juan-villota-b/Analizador-Trifasico-IoT/documentation/diagrama-de-bloques-v2.png

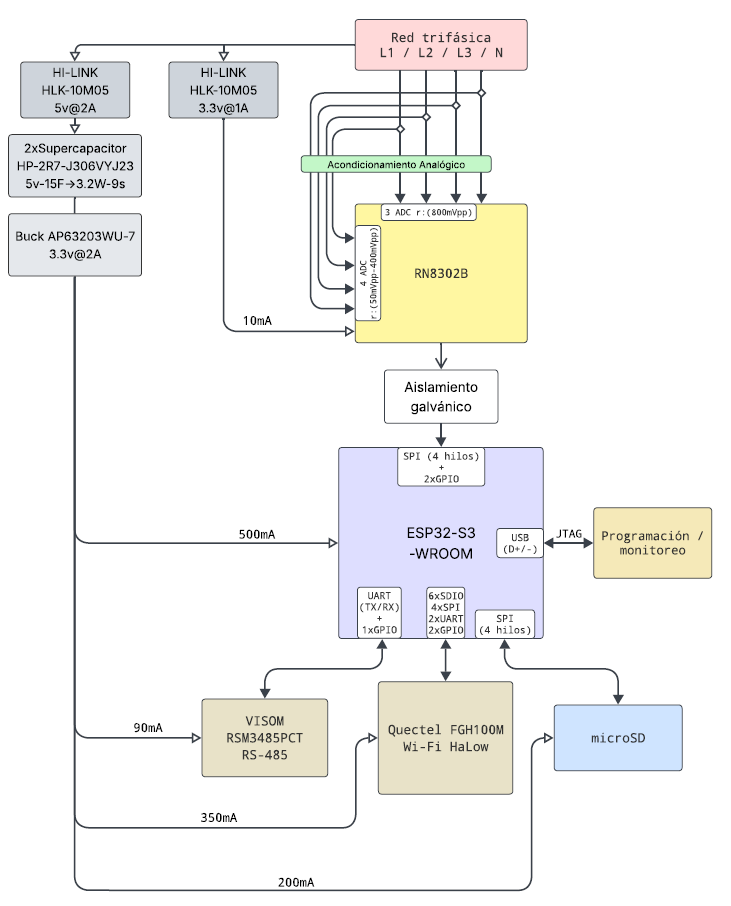
documentation/diagrama-de-bloques-v2.png
