juan-villota-b/Analizador-Trifasico-IoT/references/reference-designs/EVALLSTPM34-V3/evalstpm34_cad/EVALSTPM33 V3 BOM.xlsx

Sheet: STPM33 V3
 |  | STPM33 V3
item | qty | reference designator | value/type | footprint | assembly instructions | distrelec | rs | other provider | part number name/notes
1 | 9 | C2,C6,C7,C8,C19,C22,C27,C29,C32 | 100n | sm/c_0603 |  | 823499 |  |  | or equivalent
2 | 11 | C9,C11,C12,C13,C14,C15,C18,C21,C26,C28,C31 | 150p | sm/c_0402 |  | 831827 |  |  | or equivalent
3 | 3 | C10,C25,C33 | 10n | sm/c_0603 |  | 830121 |  |  | or equivalent
4 | 2 | C16,C17 | 15p | sm/c_0603 |  | 838382 |  |  | or equivalent
5 | 1 | C3 | 4.7U Tantalio | sm/ct_7343_12 |  |  |  | Farnell | 9753800
6 | 1 | C20 | 4.7u | sm/c_0805 |  | 823504 |  |  | or equivalent
7 | 1 | C23 | 100u 10V | CPCYL/D.200/LS.100/.031 |  |  |  | Farnell | 2346495
8 | 1 | C24 | 22n | sm/c_0603 |  | 823493 |  |  | or equivalent
 |  | C34 | 22n | sm/c_0603 | NON MONTARE
9 | 2 | C30,C1 | 1u | sm/c_0603 |  | 823495 |  |  | or equivalent
10 | 3 | D1,D2,D3 | ESDAXLC6-IBU2 | SM/C_0201 |  |  |  | STMicroelectronics
11 | 3 | DL1,DL2,DL3 | Low pwr SMD LED | LEDSMD |  | 631039 |  |  | or equivalent
12 | 1 | J1 | USB connector | Micro USB |  |  |  | Molex | 47590-0001
 |  | J2 |  |  | NON MONTARE
13 | 2 | J4,J11 | 1 row male header 2.54mm | BLKCON.100/VH/TM1SQS/W.100/3 |  | 127232 |  |  | or equivalent
14 | 2 | J5,J6 | 2 rows male header 2.54mm | BLKCON.100/VH/TM2OE/W.200/8 |  | 127234 |  |  | or equivalent
15 | 1 | J7 | PCB supply screw connector | MORS2 |  | 140276 |  |  | or equivalent
16 | 2 | J8,J9 | THT PCB Faston Connector | FASTON |  | 450280 |  |  | or equivalent
 |  | J10 | THT PCB Faston Connector | FASTON | NON MONTARE
17 | 6 | L1,L2,L3,L4,L5,L6 | TDK Ferrite Beads MM71608Y152E | SM/R_0603 |  |  |  | Farnell | 1855387RL
 |  | L7 | TDK Ferrite Beads MM71608Y152E | SM/R_0603 | NON MONTARE
18 | 1 | RS1 | BKW-M-R0003-5.0 | ISABH_SHUNT |  |  |  | Isabellenhuette | BKW-M-R0003-5.0
19 | 5 | R1,R7,R8,R9,R10 | 10K | SM/R_0603 |  |  |  |  | resistor, 1% tol., 100ppm/°C
20 | 1 | R2 | 22K | SM/R_0603 |  |  |  |  | resistor, 1% tol., 100ppm/°C
21 | 2 | R3,R11 | 100R | SM/R_0603 |  |  |  |  | resistor, 1% tol., 100ppm/°C
22 | 1 | R4 | 1M | SM/R_0603 |  |  |  |  | resistor, 1% tol., 100ppm/°C
23 | 3 | R5,R6,R28 | 4.7K | SM/R_0603 |  |  |  |  | resistor, 1% tol., 100ppm/°C
24 | 3 | R12,R13,R14 | 270K miniMELF resistor | SM/R_1206 |  | 713132 |  |  | or equivalent
 |  | R23,R24,R25 | 270K miniMELF resistor | SM/R_1206 | NON MONTARE
25 | 1 | R15 | 470R miniMELF resistor | SM/R_1206 |  | 713066 |  |  | or equivalent
 |  | R26 | 470R miniMELF resistor | SM/R_1206 | NON MONTARE
26 | 1 | R21 | 6R miniMELF resistor | SM/R_1206 |  | 713021 |  |  | or equivalent
 |  | R16 | 6R miniMELF resistor | SM/R_1206 | NON MONTARE
27 | 4 | R17,R18,R20,R22 | 1K | SM/R_0603 |  |  |  |  | resistor, 1% tol., 100ppm/°C
 |  | R19 | 0R | SM/R_0603 | NON MONTARE
28 | 1 | R27 | 470R | SM/R_0603 |  |  |  |  | resistor, 1% tol., 100ppm/°C
29 | 1 | SW1 | 3-way SPST Dip-Switch | DIP.100/6/W.300/L.375 |  |  | 745-5167
30 | 1 | T2 | VAC 4626-X002 | BLKCON.100/VH/TM1SQS/W.100/2 |  |  |  | Vacuumschmelze | 4626-X002
 | 1 | T1 | VAC 4626-X002 | BLKCON.100/VH/TM1SQS/W.100/2 | NON MONTARE
31 | 1 | U1 | CP2102 | QFN28L 5X5 0.5 |  |  |  | SiLabs | CP2102-GM
32 | 1 | U2 | STISO621 | SOG.050/8/WG.275/L.250 |  |  |  | STMicroelectronics | Si8621EC-B-IS
33 | 1 | U3 | STPM33 | QFN32L 5X5 0.5 |  |  |  | STMicroelectronics
34 | 1 | Y1 | 16MHz Crystal, HC49US package | XTAL |  | 335035

Sheet: PUBLISHING
 | EVALSTPM33 V3
 | Bill of material
Description | Designator | Qty | Value | Footprint | Manufacturer | Comment
SMD capacitor | C2,C6,C7,C8,C19,C22,C27,C29,C32 |  | 100n | sm/c_0603
SMD capacitor | C9,C11,C12,C13,C14,C15,C18,C21,C26,C28,C31 |  | 150p | sm/c_0402
SMD capacitor | C10,C25,C33 |  | 10n | sm/c_0603
SMD capacitor | C16,C17 |  | 15p | sm/c_0603
SMD capacitor | C20 |  | 4.7u | sm/c_0805
SMD capacitor | C3 |  | 4.7u Tantalium | sm/ct_7343_12 | Farnell
Electrolytic capacitor | C23 |  | 100u 10V | CPCYL/D.200/LS.100/.031 | Farnell
SMD capacitor | C24 |  | 22n | sm/c_0603
SMD capacitor | C34 |  | 22n | sm/c_0603 |  | DO NOT MOUNT
SMD capacitor | C30,C1 |  | 1u | sm/c_0603
SMD Transient suppressor | D1,D2,D3 |  | ESDAXLC6-IBU2 | SM/C_0201 | STMicroelectronics
SMD LED | DL1,DL2,DL3 |  |  | LEDSMD
microUSB female plug | J1 |  |  | Micro USB | Molex
 | J2 |  |  |  |  | DO NOT MOUNT
1 row male header 2.54mm | J4,J11 |  |  | BLKCON.100/VH/TM1SQS/W.100/3
2 rows male header 2.54mm | J5,J6 |  |  | BLKCON.100/VH/TM2OE/W.200/8
16AWG 5.08mm screw connector | J7 |  |  | MORS2
PCB TH Faston terminal | J8,J9 |  |  | FASTON
PCB TH Faston terminal | J10 |  |  | FASTON |  | DO NOT MOUNT
SMD ferrite bead | L1,L2,L3,L4,L5,L6 |  | TDK Ferrite Beads MM71608Y152E | SM/R_0603 | Farnell
SMD ferrite bead | L7 |  | TDK Ferrite Beads MM71608Y152E | SM/R_0603 | Farnell | DO NOT MOUNT
Shunt current sensor | RS1 |  | BKW-M-R0003-5.0 | ISABH_SHUNT | Isabellenhuette
SMD resistor | R1,R7,R8,R9,R10 |  | 10K | SM/R_0603
SMD resistor | R2 |  | 22K | SM/R_0603
SMD resistor | R3,R11 |  | 100R | SM/R_0603
SMD resistor | R4 |  | 1M | SM/R_0603
SMD resistor | R5,R6,R28 |  | 4.7K | SM/R_0603
SMD resistor | R12,R13,R14 |  | 270K miniMELF resistor | SM/R_1206
SMD resistor | R23,R24,R25 |  | 270K miniMELF resistor | SM/R_1206 |  | DO NOT MOUNT
SMD resistor | R15 |  | 470R miniMELF resistor | SM/R_1206
SMD resistor | R26 |  | 470R miniMELF resistor | SM/R_1206 |  | DO NOT MOUNT
SMD resistor | R16 |  | 6R miniMELF resistor | SM/R_1206 |  | DO NOT MOUNT
SMD resistor | R17,R18,R20,R22 |  | 1K | SM/R_0603
SMD resistor | R19 |  | 0R | SM/R_0603 |  | DO NOT MOUNT
SMD resistor | R21 |  | 6R miniMELF resistor | SM/R_1206
SMD resistor | R27 |  | 470R | SM/R_0603
3-way 2-state DIP switch | SW1 |  |  | DIP.100/6/W.300/L.375
Current Transformer | T1 |  | VAC 4626-X002 | BLKCON.100/VH/TM1SQS/W.100/2 | Vacuumschmelze | DO NOT MOUNT
Current Transformer | T2 |  | VAC 4626-X002 | BLKCON.100/VH/TM1SQS/W.100/2 | Vacuumschmelze
CP2102 IC-QFN28 | U1 |  | CP2102 | QFN28L 5X5 0.5 | SiLabs
STISO621 IC-SO8W | U2 |  | STISO621W | SOG.050/8/WG.275/L.250 | STMicroelectronics
STPM34 IC-QFN32 | U3 |  | STPM34 | QFN32L 5X5 0.5 | STMicroelectronics
16MHz Crystal, HC49US package | Y1 |  | 16MHz Crystal, HC49US package | XTAL
