juan-villota-b/Analizador-Trifasico-IoT/references/reference-designs/EVALLSTPM34-V3/LCSC__WM2611110226_20261111053323.csv

LCSC Part Number | Manufacture Part Number | Manufacturer | Customer NO. | Package | Description | RoHS | Quantity | Unit Price($) | Ext.Price($) | Estimated lead time (business days) | Updated lead time | Date Code / Lot No.
C7436773 | HP-2R7-J306VYJ23 | KAMCAP |  | Through Hole,D18xL26mm | 0%~+30% 2.7V 30F 22mΩ@1kHz Through Hole,D18xL26mm Aluminum Electrolytic Capacitors | YES | 2 | 1.47 | 2.94
C19674267 | 049SS2-8.192F12DZLAL | HCI |  | HC-49S-SMD | Crystal 8.192MHz ±20ppm 12pF 60Ω HC-49S-SMD | YES | 5 | 0.1346 | 0.67
C53144700 | TF-CARD-9P | BXCONN |  | SMD | -25℃~+90℃ Push-Push 1.8mm Connector and Ejector MicroSD Card (TF Card) SMD PC Card Sockets RoHS | YES | 10 | 0.0459 | 0.46
C882105 | RSM3485PCT | VISOM |  | DIP-9 | 3.15V~3.45V 9.6Kbps 64 No DIP-9 Drivers, Receivers, Transceivers | YES | 1 | 2.4222 | 2.42
C2913197 | ESP32-S3-WROOM-1-N4 | ESPRESSIF |  | SMD,25.5x18mm | 2.4GHz ESP32-S3 On-board PCB Antenna -103.5dBm SMD,25.5x18mm RF Transceiver Modules and Modems RoHS | YES | 1 | 4.3075 | 4.31
C49291885 | C50126V-4P0G56 | JXTCONN |  | Through Hole,P=5mm | 0.5~2.5 18A -40℃~+105℃ 250V 1x4P Green 14~26 Through Hole 4 1 5mm Through Hole,P=5mm Wire to Board | YES | 5 | 0.1402 | 0.70
C19189087 | HX PJ-320A-3P DIP | hanxia |  | Through Hole | 3.5mm Headphone Jack 500mA 30V Through Hole | YES | 10 | 0.0424 | 0.42
C7465187 | B0503S-1WR3 | EVISUN |  | SIP,11.7x6mm | Isolated Module DC DC Converter 3.3V 303mA 4.5V~5.5V Input | YES | 1 | 1.0919 | 1.09
C47115461 | HX1002-GEC | HEXIN |  | SOT-23-5L | Buck Switching Regulator IC Fixed 3.3V 1 Output SOT-23-5L | YES | 10 | 0.074 | 0.74
C571196 | ISO7741DWR | TI |  | SOIC-16-300mil | 100kV/us SOIC-16-300mil Digital Isolators RoHS | YES | 1 | 1.5216 | 1.52
C22381391 | RN8302B(V3) | RENERGY |  | LQFP-44(10x10) | 3V~3.6V SPI 4.4mA LQFP-44(10x10) Energy Metering | YES | 1 | 1.7333 | 1.73
C1527439 | MOV-14D471K | BOURNS |  | Through Hole,P=7.5mm | 470V 4.5kA Varistor Through Hole,P=7.5mm | YES | 3 | 0.4328 | 1.30
C861150 | RT0603BRD07165KL | YAGEO |  | 0603 | 100mW 165kΩ 75V Thin Film Resistor ±25ppm/℃ ±0.1% 0603 Chip Resistor - Surface Mount RoHS | YES | 20 | 0.0516 | 1.03
C2791987 | HQ03W5F510KT5E | UNI-ROYAL |  | 0603 | 5.1Ω ±1% 200mW 0603 Thick Film Resistor AEC-Q200 | YES | 10 | 0.0061 | 0.06
C54920849 | HRC0603F1200ENTN | HWA CHN |  | 0603 | 100mW 120Ω 50V Thick Film Resistor ±1% ±100ppm/℃ 0603 Chip Resistor - Surface Mount | YES | 100 | 0.0012 | 0.12
C2758800 | HP122WJ039JT4E | UNI-ROYAL |  | 2512 | 3.9Ω 2W 300V Thick Film Resistor ±5% 2512 Chip Resistor - Surface Mount | YES | 10 | 0.0324 | 0.32
C2907002 | FRC0603F1001TS | FOJAN |  | 0603 | 1kΩ ±1% 100mW 0603 Thick Film Resistor | YES | 100 | 0.0021 | 0.21
C53224186 | 1RC0603F1002 | SAE |  | 0603 | 10kΩ 100mW 75V Thick Film Resistor ±100ppm/℃ ±1% 0603 Chip Resistor - Surface Mount | YES | 100 | 0.0021 | 0.21
C52746092 | HLK-10M05T | HI-LINK |  | Through Hole,39x23.5mm | Through Hole,39x23.5mm AC DC Converters RoHS | YES | 1 | 3.1018 | 3.10
C55058769 | JFC2410-0200TS | JDTfuse |  | 2410 | Surface Mount Fuse 200mA 250V 2410 Fuses | YES | 5 | 0.1124 | 0.56
C908219 | SM712 | FUXINSEMI |  | SOT-23 | 20VC Clamp 18A Ipp ESD DIODE SOT-23 | YES | 10 | 0.0424 | 0.42
C145190 | MBRA210LT3G | onsemi |  | SMA(DO-214AC) | Diode 10V 2A Surface Mount SMA(DO-214AC) | YES | 5 | 0.333 | 1.67
C165071 | 0603B333K500CT | Walsin |  | 0603 | 33nF ±10% 50V Ceramic Capacitor X7R 0603 | YES | 50 | 0.0099 | 0.50
C41435083 | RVT1E4R7M0405 | ROQANG |  | SMD,D4xL5.4mm | 4.7uF ±20% 25V Aluminum Electrolytic Capacitors | YES | 20 | 0.022 | 0.44
C19666 | CL10A475KO8NNNC | Samsung Electro-Mechanics |  | 0603 | 4.7uF ±10% 16V Ceramic Capacitor X5R 0603 | YES | 10 | 0.0151 | 0.15
C346207 | CL10C150JB81PNC | Samsung Electro-Mechanics |  | 0603 | 15pF ±5% 50V Ceramic Capacitor C0G 0603 | YES | 50 | 0.0133 | 0.67
C42429166 | ZNR4020ST4R7M | ZE |  | SMD,4x4mm | 2A 4.7uH ±20% 75mΩ 2.5A Magnetic Shielded Inductor SMD,4x4mm Fixed Inductors RoHS | YES | 5 | 0.043 | 0.22
