juan-villota-b/Analizador-Trifasico-IoT/hardware/altium/Project Outputs for Analizador_trifasico_IoT_pcb/Analizador_trifasico_IoT_pcb.xlsx

Name | Description | Quantity | Manufacturer 1 | Manufacturer Part Number 1 | Supplier 1 | Supplier Part Number 1 | Supplier Unit Price 1 | Supplier Subtotal 1
YAGEO CC0603JRNPO9BN150 | Capacitance:15pF Tolerance:±5% Tolerance:±5% Voltage Rating:50V Temperature Coefficient:C0G | 2 | Chinocera | HGC0603G0150J500NTHJ | LCSC | C465156
CL10B105KB8NQNC | Capacitance:1uF Tolerance:±20% Tolerance:±20% Voltage Rating:50V Ripple Current:- Equivalent Series Resistance(ESR):- Diameter:4mm Height - Seated (Max):5.4mm Lifetime:1000hrs@105℃ Operating Temperature:-45℃~+105℃ Operating Temperature:-45℃~+105℃ | 2 | Samsung Electro-Mechanics | CL10B105KB8NQNC | LSCS | C5199872
AIDE CAPACITOR 0603X7R104K250NT | CAP CER 100nF 25V X7R 0603 | 12 | AIDE CAPACITOR | 0603X7R104K250NT | LCSC | C48579280
muRata GRM21BR61C106KE15L | CAP CER 10uF 16V X5R 0805 | 8 | Murata | GRM21BR61C106KE15L | LCSC | C77075 | 0.0366 | 0.366
hp-2r7-j306vyj23 | Capacitance:30F Tolerance:0%~+30% Tolerance:0%~+30% Voltage Rating:2.7V Pin Spacing:7.5mm Diameter:18mm Height - Seated (Max):26mm Operating Temperature:-40℃~+70℃ Operating Temperature:-40℃~+70℃ | 2 | KAMCAP | HP-2R7-J306VYJ23 | LCSC | C7436773
Samsung Electro-Mechanics | CAP CER 4.7uF 16V X5R 0603 | 1 | Samsung Electro-Mechanics | CL10A475KO8NNNC | LCSC | C19666 | 0.0151 | 0.151
Chinocera HGC0805R5226K100NSLJ | CAP CER 22uF 10V X5R 0805 | 3 | Suzhou Hangjing Elec&Tech Co.,Ltd | 049SS2-8.192F12DZLAL | LCSC | C7432777
rvt1e4r7m0405 | Capacitance:4.7uF Tolerance:±20% Tolerance:±20% Voltage Rating:25V Diameter:4mm Height - Seated (Max):5.4mm Operating Temperature:-40℃~+105℃ Operating Temperature:-40℃~+105℃ | 1 | Roqang | RVT1E4R7M0405 | LCSC | C41435083 | 0.0198 | 0.396
AIDE CAPACITOR 0603X7R333J500NT | 33nF X7R ±5% 50V 0603 Ceramic Capacitors RoHS | 14 | AIDE CAPACITOR | 0603X7R333J500NT | LCSC | C49326639
ms2a40lws | 30V 1 Independent 125mV@1mA 1.5A SOD-123F Single Diodes RoHS | 3 | onsemi | MBRA210LT3G | LCSC | C145190 | 0.333 | 1.67
2V | LED RED CLEAR 0805 SMD | 1 | XINGLIGHT | XL-2012SURC | LCSC | C965812 | 0.0071 | 0.71
2.9V | LED GREEN CLEAR 0805 SMD | 2 | XINGLIGHT | XL-2012UGC | LCSC | C965815 | 0.0067 | 0.67
C908219 | Polarity:Bidirectional Reverse Stand-Off Voltage (Vrwm):7V Clamping Voltage:20V Peak Pulse Current (Ipp):18A Peak Pulse Power Dissipation (Ppp):360W Voltage - Breakdown:13.3V Reverse Leakage Current (Ir):1uA Number of Channels:2 Operating Temperature:-55℃ | 1 | FUXINSEMI | SM712 | LCSC | C908219 | 0.034 | 0.34
JDTfuse JFC2410-0200TS | Surface Mount Fuse 200mA 250V 2410 Fuses | 3 | Shenzhen JDT Fuse | JFC2410-0200TS | LCSC | C55058769 | 0.099 | 0.495
Yanchuang SCBM160808U090T | 10mΩ 15Ω@100MHz 0603 Ferrite Beads and Chips | 7 | Yanchuang | SCBM160808U090T | LCSC | C52205324
USB C | 3A USB 3.1 1 Surface Mount 16P Female -40℃~+85℃ Type-C SMD USB Connectors ROHS | 1 | SHOU HAN | TYPE-C-3.1-16PIN | LCSC | C7507405 | 0.068 | 0.68
Connector 3pos | 1x3P 10A -40℃~+105℃ 300V Green 14~26 Through Hole 5mm 2.5 1 3 Plugin,P=5mm Screw Terminal Blocks ROHS | 1 | MAX | MX126-5.0-03P-GN01-Cu-S-A | LCSC | C5188435
znr4030st3r9m | Inductance:3.9uH Tolerance:±20% Tolerance:±20% Current Rating:2.3A Current - Saturation(Isat):3.3A DC Resistance(DCR):57mΩ Type:Magnetic Shielded Inductor | 1 | ZE | ZNR4030ST3R9M | LCSC | C42429307
C52746092 | 10W Ultra-Compact Power Module | 1 | Hi-Link | HLK-10M05T | LCSC | C52746092 | 2.88 | 2.88
SAE 1RC0603F1002 | 10kΩ 100mW 75V Thick Film Resistor ±100ppm/℃ ±1% 0603 Chip Resistor - Surface Mount | 13 | SAE | 1RC0603F1002 | LCSC | C53224186 | 0.0021 | 0.21
FOJAN FRC0603F1001TS | RES 1kΩ ±1% 100mW 0603 | 17 | FOJAN | FRC0603F1001TS | LCSC | C2907002 | 0.002 | 0.2
RES 3900mΩ ±5% 2W 2512 | Type:Thick Film Resistor Resistance:3.9Ω Tolerance:±5% Tolerance:±5% Power(Watts):2W Voltage-Supply(Max):300V Operating Temperature:-55℃~+155℃ Operating Temperature:-55℃~+155℃ | 2 | sds | dsd | LCSC | sds
HWA CHN HRC0603F1200ENTN | 100mW 120 50V Thick Film Resistor ±1% ±100ppm/℃ 0603 Chip Resistor - Surface Mount | 1 | HWA CHN | HRC0603F1200ENTNV | LCSC | C54920849
RES 120Ω ±1% 100mW 0603 | RES 120Ω ±1% 100mW 0603 | 2 | HWA CHN | HRC0805F1200FNTN | LCSC | C54921099
84R5 1/10W | 100mW Thick Film Resistor 50V ±100ppm/℃ ±1% 84.5Ω 0603 Chip Resistor - Surface Mount ROHS | 1 | LIZ | CR0603FA84R5G | LCSC | C101216
330R 1/10W | RES SMD 330R OHM 5% 1/10W 0603 | 1 | FOJAN | FRC0603J331 TS | LCSC | C2907152 | 0.0013 | 0.13
SEI(Stackpole Electronics Inc.) | RES 5.1Ω ±1% 400mW 0603 | 8 | Uniroyal | HQ03W5F510KT5E | LCSC | C2791987 | 0.0061 | 0.061
BOURNS CR0603-FX-1653ELF | RES 165kΩ ±0.1% 100mW 0603 | 18 | Yageo Group | RT0603BRD07165KL | LCSC | C861150 | 0.0516 | 1.03
UNI-ROYAL HP05W3F100JT5E | 5.11kΩ 100mW 50V Thick Film Resistor ±1% ±100ppm/℃ 0603 Chip Resistor - Surface Mount | 2 | HWA CHN | HRC0603F5111ENTN | LCSC | C55098456
MOV-14D471K | 470 V 4.5 kA Varistor 1 Circuit Through Hole Disc 14mm | 3 | Bourns | MOV-14D471K | LCSC | C1527439 | 0.4328 | 1.3
Sw | SWITCH TACTILE SPST-NO 0.05A 12V | 2 |  |  | LCSC | C2888509
RN8302B(v3) | Meter Type:Polyphase Energy Metering IC Number of Channels:- Tolerance:0.1% Voltage - Supply:3V~3.6V Voltage - Supply:3V~3.6V Dynamic Range:10000:1 Interface:SPI Current - Supply:4.4mA Current - Supply:4.4mA Operating Temperature:-40℃~+85℃ Operating Tempe | 1 | Renergy | RN8302B(V3) | LCSC | C22381391 | 1.73 | 1.73
C571196 | Number of Forward Channels:3 Number of Reverse Channels:1 Data Rate(Max):100Mbps Default Output:High Level Isolation Voltage(Vrms):5000 CMTI(kV/us):100kV/us Propagation Delay(tpd):10.7ns Features:Channel direction configurable；Fail-safe output Voltage - S | 1 | Texas Instruments | ISO7741DWR | LCSC | C571196 | 1.52 | 1.52
AP63203WU-7 | Buck Switching Regulator IC Positive Fixed 3.3V 1 Output 2A SOT-23-6 Thin, TSOT-23-6 | 1 | Diodes Inc. | AP63203WU-7 | LCSC | C780769
b0503s-1wr3_c7465187 | Type:Plastic encapsulated type Number of Outputs:1 Output Power:1W Voltage - Supply:4.5V~5.5V Voltage - Supply:4.5V~5.5V Conversion Efficiency:74% Conversion Efficiency:74% Output Voltage:3.3V Output Voltage:3.3V Output Current(Max):303mA Output Current(M | 1 | EVISUN | B0503S-1WR3 | LCSC | C7465187 | 0.8736 | 0.8736
hx pj-320a-3p dip | Connector Type:3.5mm Headphone Jack Current Rating:500mA Voltage Rating (Max):30V Operating Temperature:-30℃~+70℃ Operating Temperature:-30℃~+70℃ Rank Number:TRS Mounting Style:Right-Angle Body Height:5mm Length:14.1mm Width:6mm | 4 | Hanxia | HX PJ-320A-3P DIP | LCSC | C19189087 | 0.0403 | 0.403
c50126v-4p0g56 | Number of Positions or Pins:1x4P Pitch:5mm Color:Green Mounting Type:Through Hole Number of Pins:4P Number of Rows:1 Number of PINs Per Row:4 Current Rating:18A Voltage Rating (Max):250V Wire Gauge - AWG:14~26 Wire Gauge - mm2:0.5~2.5 Wire Gauge - mm2:0.5 | 1 | JXTCONN | C50126V-4P0G56 | LCSC | C49291885 | 0.1122 | 0.561
USBLC6-2SC6 | TVS DIODE 5.25V 17V SOT23-6 | 1 | STMicroelectronics | USBLC6-2SC6 | LCSC | C7519 | 0.1639 | 0.8195
esp32-s3-wroom-1-n4 | Utilized IC / Part:ESP32-S3 Wireless Standard:Bluetooth5.0 Interface Type:I2C；GPIO；UART；SPI；USB；I2S Frequency:2.4GHz Antenna Type:On-board PCB Antenna Output Power:20.5dBm Output Power:20.5dBm Voltage - Supply:3V~3.6V Voltage - Supply:3V~3.6V Receive Cur | 1 | Espressif Systems | ESP32-S3-WROOM-1-N4 | LCSC | C2913197 | 4.31 | 4.31
rsm3485pct | Data Rate:9.6Kbps ESD Protect:Yes Voltage - Supply:3.15V~3.45V Voltage - Supply:3.15V~3.45V isolation:2500V Number of Nodes:64 Quiescent Current:30mA Automatic flow control:No Operating Temperature:-40℃~+85℃ Operating Temperature:-40℃~+85℃ | 1 | Visom | RSM3485PCT | LCSC | C882105 | 2.3 | 2.3
tf-card-9p | Card Connection Mode:Push-Push Card Type:MicroSD Card (TF Card) Connector Type:Connector and Ejector Height Above Board:1.8mm Operating Temperature:-25℃~+90℃ Operating Temperature:-25℃~+90℃ | 1 | BXCONN | TF-CARD-9P | LCSC | C53144700 | 0.0427 | 0.427
049ss2-8.192f12dzlal | Type:Crystal Oscillator Frequency:8.192MHz Normal temperature Frequency Tolerance:±20ppm Normal temperature Frequency Tolerance:±20ppm Load Capacitance:12pF Frequency Stability:±100ppm Frequency Stability:±100ppm Equivalent Series Resistance(ESR):60Ω Oper | 1 | HCI | 049SS2-8.192F12DZLAL | LCSC | C19674267 | 0.1158 | 0.579
