juan-villota-b/Analizador-Trifasico-IoT/documentation/Diagrama_de_bloques_final.pdf

# Analizador Trifásico IoT — Diagrama de bloques final

### 3P4W · 120/208 V · medición directa · aislamiento galvánico · RS-485 · Wi-Fi HaLow

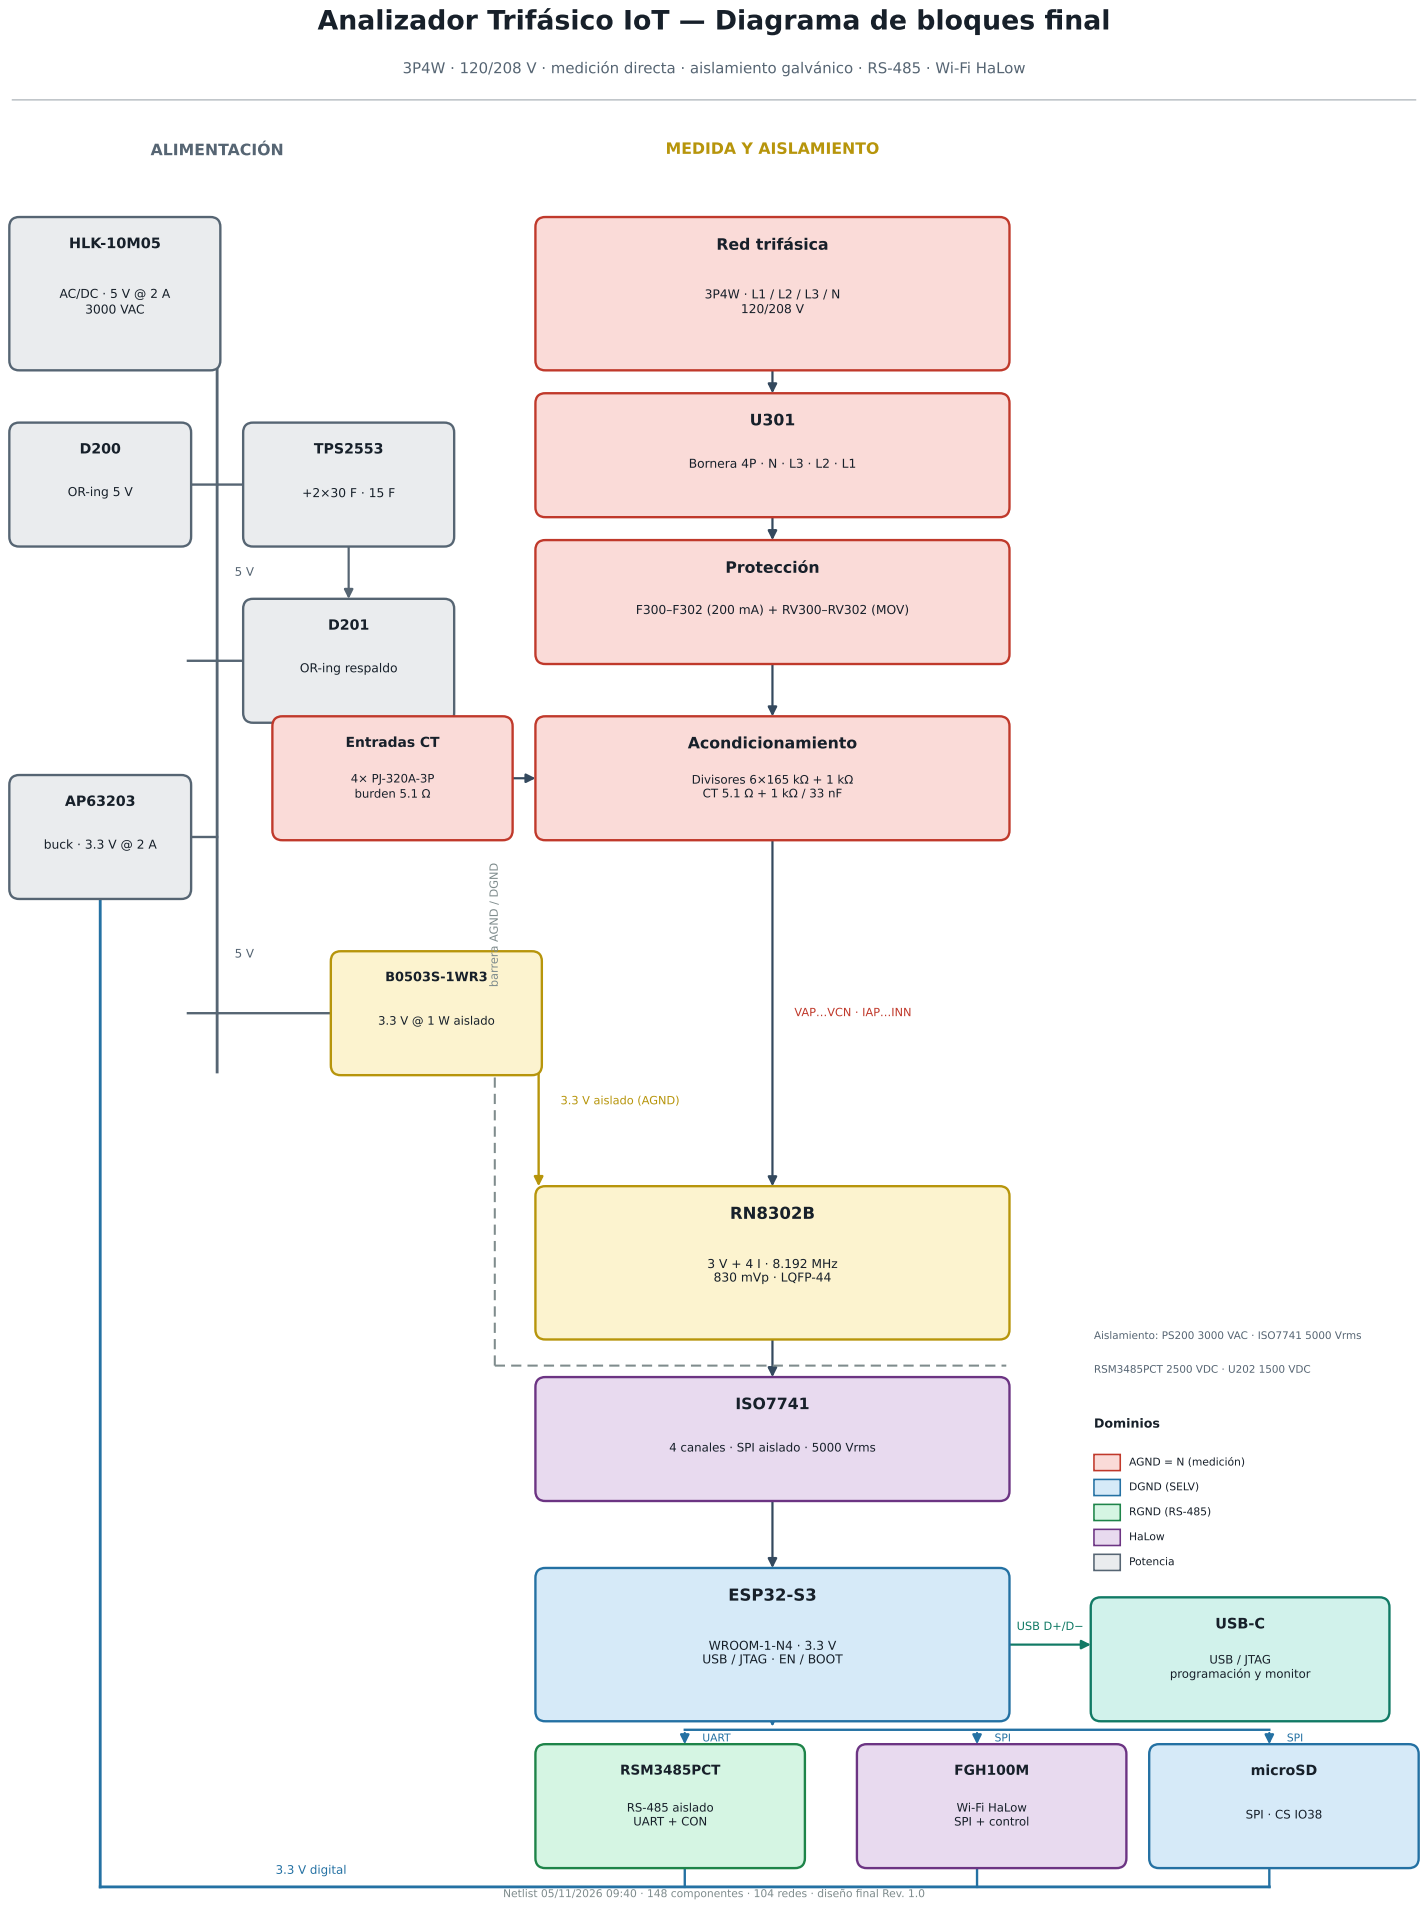
[picture p3: page 1]

VAP…VCN · IAP…INN

4 canales · SPI aislado · 5000 Vrms

WROOM-1-N4 · 3.3 V
USB / JTAG · EN / BOOT

Netlist 05/11/2026 09:40 · 148 componentes · 104 redes · diseño final Rev. 1.0
