juan-villota-b/Analizador-Trifasico-IoT/documentation/diagrama de bloques.pdf

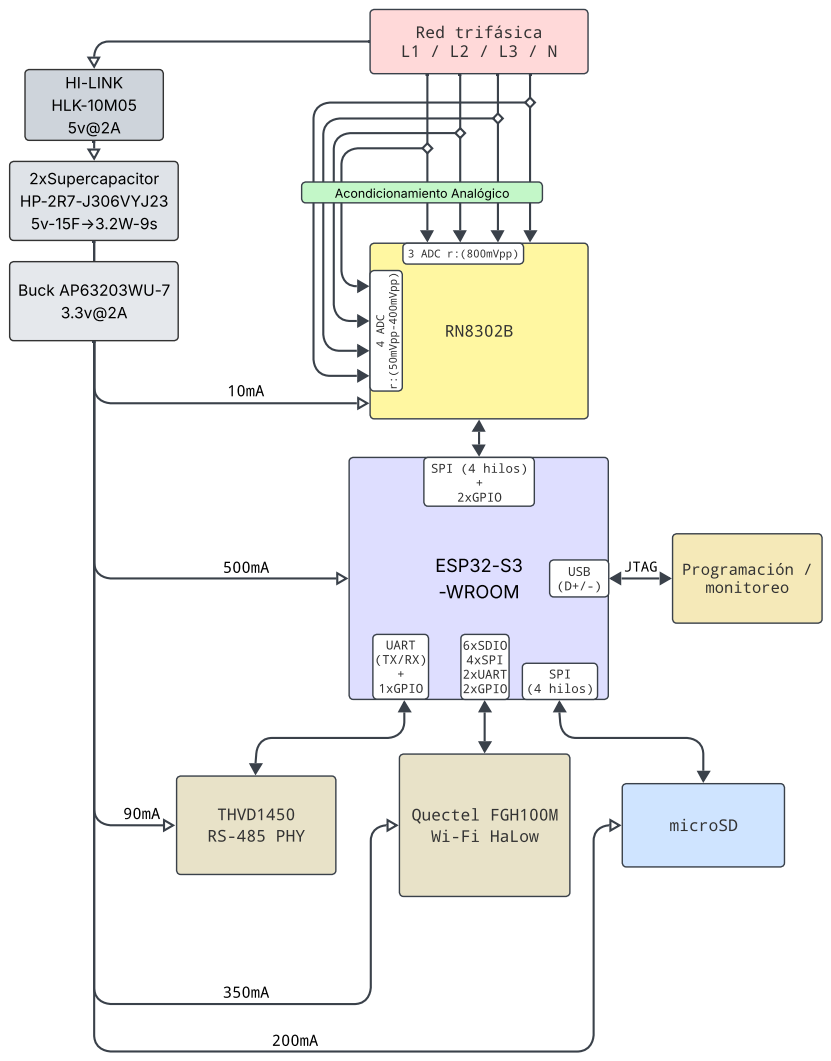
[picture p4: page 1]
ESP32-S3 -WROOM; THVD1450 RS- 485 PHY; UART ( TX/ RX) + 1xGPI O; 6xSDI O 4xSPI 2xUART 2xGPI O; SPI ( 4 hi l os); 3 ADC r : ( 800mVpp); Acondicionamiento Analógico; + 2xGPI O; 2xSupercapacitor HP-2R7-J306VYJ23 5v-15F? 3.2W-9s; USB ( D+/ - ); JTAG; HI-LINK HLK-10M05 5v@2A; Buck AP63203WU-7 3.3v@2A

Red t r i f ási ca

SPI ( 4 hi l os)

Pr ogr amaci ón /
moni t or eo

Quect el FGH100M
Wi - Fi HaLow

mi cr oSD
