juan-villota-b/Analizador-Trifasico-IoT/references/reference-designs/EVALLSTPM34-V3/evalstpm34_cad/Assembly Drawings.pdf

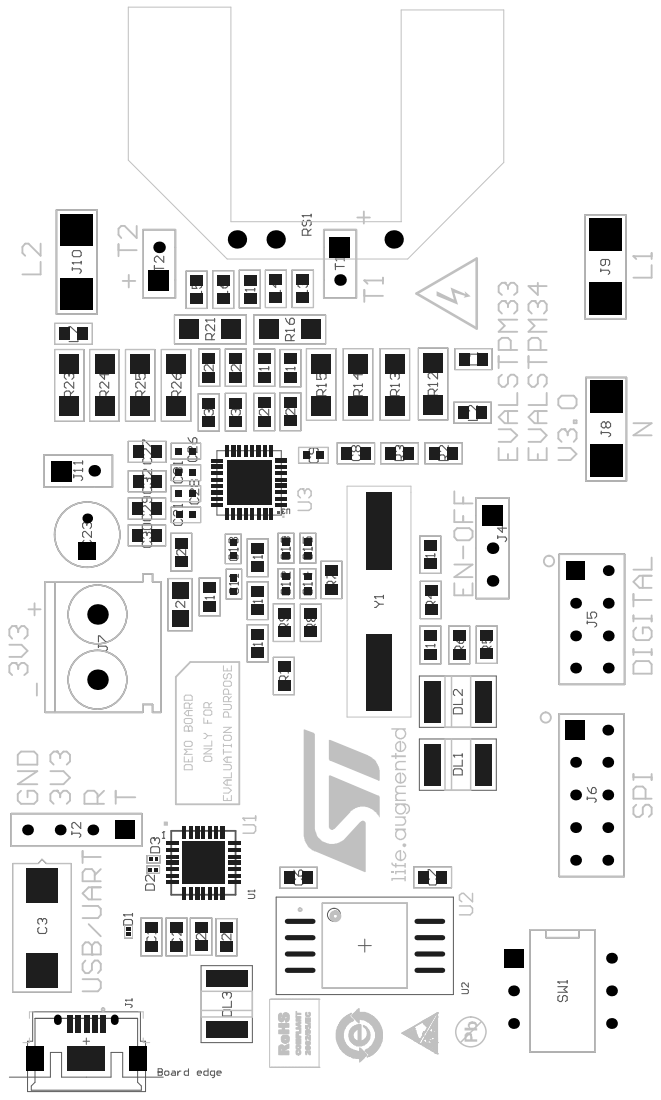
[picture p5: page 1]

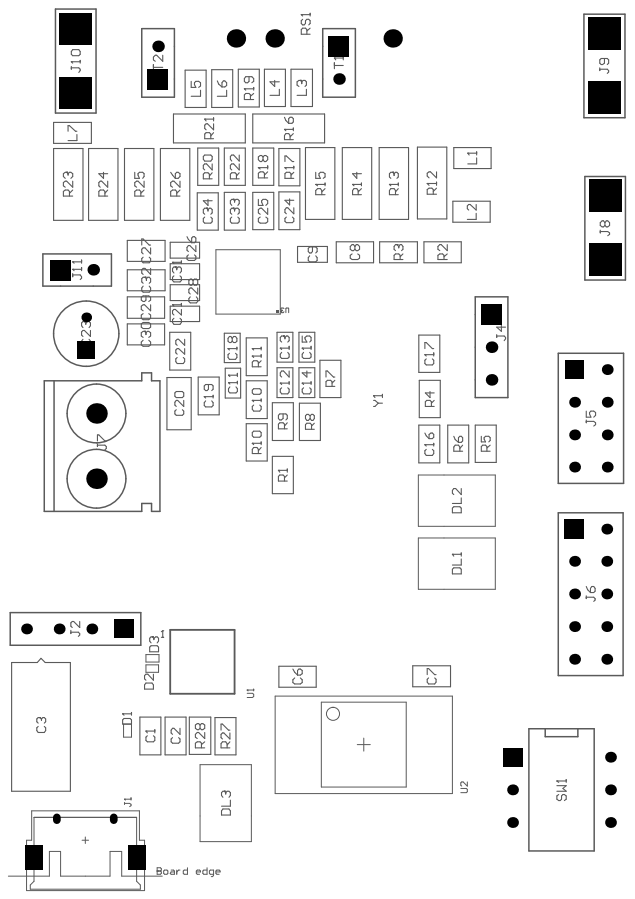
[picture p6: page 2]
