juan-villota-b/Analizador-Trifasico-IoT/(list of files, drawings)

Other design files:
documentation/wifi-module-halow-xiao/PCB-module/WI-FI_HALOW_FGH100M_EXT01_V30.PrjPcb
hardware/altium/Analizador_PCB.PcbDoc
hardware/altium/ANALIZADOR_PSB.PcbDoc
hardware/altium/Analizador_trifasico_IoT_pcb.PrjPcb
hardware/altium/INTERFACES.SchDoc
hardware/altium/MAIN.SchDoc
hardware/altium/MCU.SchDoc
hardware/altium/MEASURES.SchDoc
hardware/altium/POWER.SchDoc
hardware/altium/THREE PHASES.SchDoc
references/reference-designs/HX PJ-320A-3P DIP/HX PJ-320A-3P DIP.pcbdoc
references/reference-designs/HX PJ-320A-3P DIP/HX PJ-320A-3P DIP.schdoc
references/reference-designs/WI-FI_HALOW_FGH100M_EXT01_V30/altium/WI-FI_HALOW_FGH100M_EXT01_V30.PcbDoc
