juan-villota-b/Analizador-Trifasico-IoT/references/reference-designs/WI-FI_HALOW_FGH100M_EXT01_V30/WI-FI_HALOW_FGH100M_EXT01_V30.kicad_pcb

## KiCad design references/reference-designs/WI-FI_HALOW_FGH100M_EXT01_V30/WI-FI_HALOW_FGH100M_EXT01_V30.kicad_pcb (2026-10-24)

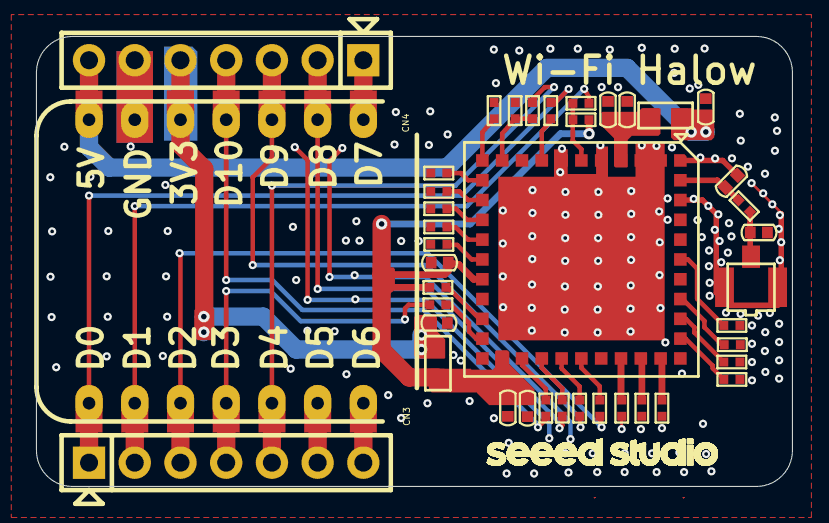
[picture p7: board WI-FI_HALOW_FGH100M_EXT01_V30.kicad_pcb from above]

Board: 2 copper layers, 42.0 x 25.0 mm, 41 parts (0 on the bottom side), 40 nets.

Parts:
C1, C2, C3, C4, C5, C6, C7, C8, C9: C0402M
CN1: CON_U.FL-R-SMT-1
CN2: CN_ESP32S3_XIAO_DIP14
CN3, CN4: HEADER_PIN_SIP7_2MM54
FB1, FB2: FB0603
R1, R2, R3, R4, R5, R6, R7, R8, R9, R10, R11, R12, R13, R14, R15, R16, R17, R18, R19, R20, R21, R22, R23, R24, R25: R0402
UM1: FGH100M-H

Connections:
3V3: C4.1, CN2.12, CN4.5, FB1.1
ANT_WIFI: C1.1, CN1.1, R1.1
ANT_WIFI_MOD: C2.1, R1.2, UM1.40
BUSY: R15.2, R17.2, UM1.10
GND: C1.2, C2.2, C3.2, C4.2, C5.2, C6.2, C7.2, C8.2, C9.2, CN1.2, CN1.3, CN2.13, CN4.6, R2.2, R3.2, R4.2, R5.2, R6.2, R7.2, R8.2, R15.1, R18.1, R19.1, R20.1, R22.1, R23.1, R24.1, UM1.1, UM1.2, UM1.3, UM1.5, UM1.7, UM1.18, UM1.21, UM1.31, UM1.38, UM1.39, UM1.41, UM1.42, UM1.43, UM1.44, UM1.45, UM1.46, UM1.47, UM1.48, UM1.49, UM1.50, UM1.51, UM1.52, UM1.53, UM1.54, UM1.55, UM1.56, UM1.57, UM1.58, UM1.59, UM1.60, UM1.61, UM1.62, UM1.63, UM1.64, UM1.65
MOD_3V3: C7.1, C8.1, C9.1, FB1.2, R9.1, R25.2, UM1.17, UM1.22
MOD_5V: C5.1, C6.1, FB2.2, UM1.4
N34310028: R6.1, UM1.30
N34310043: R7.1, UM1.29
N34310055: R8.1, UM1.28
N34310477: R18.2, UM1.11
N34310504: R19.2, UM1.12
N34310586: R20.2, UM1.13
N34310613: R22.2, UM1.14
N34310640: R23.2, UM1.15
N34310667: R24.2, UM1.16
N34311591: R25.1, UM1.19
N34312565: R5.1, UM1.32
N34312570: R4.1, UM1.33
N34312575: R3.1, UM1.34
N34312580: R2.1, UM1.36
PA02_A0_D0: CN2.1, CN3.1, R13.1
PA4_A1_D1: CN2.2, CN3.2, R10.1
PA5_A9_D9_MISO: CN2.10, CN4.3, R12.2
PA6_A10_D10_MOSI: CN2.11, CN4.4, R16.2
PA7_A8_D8_SCK: CN2.9, CN4.2, R14.2
PA8_A4_D4_SDA: CN2.5, CN3.5, R17.1
PA9_A5_D5_SCL: CN2.6, CN3.6
PA10_A2_D2: CN2.3, CN3.3, R11.2
PA11_A3_D3: CN2.4, CN3.4, R21.2
PB08_A6_D6_TX: CN2.7, CN3.7
PB09_A7_D7_RX: CN2.8, CN4.1
RESET: R13.2, UM1.8
SPI_CLK: R14.1, UM1.24
SPI_CS: R21.1, UM1.20
SPI_INT: R11.1, UM1.26
SPI_MISO: R12.1, UM1.25
SPI_MOSI: R16.1, UM1.23
VDD_5V: C3.1, CN2.14, CN4.7, FB2.1
WAKEUP_IN: R9.2, R10.2, UM1.6
