juan-villota-b/Analizador-Trifasico-IoT/(commit log)

2026-10-24 Estructura inicial del proyecto Analizador Trifasico IoT
    - hardware/altium: proyecto Altium Designer (5 hojas esquematicas + PCB)
    - hardware/libraries: biblioteca de componentes (LibPkg, SchLib, PcbLib, IntLib)
    - documentation: especificacion de arquitectura v2.0 y diagramas de bloques
    - references: datasheets, notas de aplicacion y disenos de referencia
    - .gitignore/.gitattributes: exclusiones de Altium y marcado de binarios
2026-10-24 README: reescribe con base en el diagrama de bloques V2
    - Arquitectura actualizada: HLK-10M05, AP63203WU-7, supercaps 15F,
    RSM3485PCT, ISO7741, ESP32-S3-WROOM-1-N4
    - Agrega diagrama Mermaid, mapa de interfaces del ESP32-S3
    - Agrega presupuesto de corriente del riel 3.3V (1150/2000 mA)
    - Documenta Last Gasp (3.2 W durante 9 s)
    - Advierte que Especificacion de Arquitectura.md esta desactualizada
2026-10-24 Restaura documentacion eliminada accidentalmente
    Recupera Especificacion de Arquitectura.md y diagrama de bloques.pdf
    desde el commit inicial 004fa68.
2026-10-24 README: usa la imagen del diagrama de bloques V2 en lugar de Mermaid
    - Agrega documentation/diagrama-de-bloques-v2.png (731x906)
    - Reemplaza el bloque Mermaid por la imagen del diagrama
    - Enlaza tambien la version PDF
    - Actualiza el arbol de estructura
2026-10-24 DOC: agrega CONTRIBUTING.md con la guia de trabajo en equipo
    - Configuracion inicial (Git, SSH, clonado, librerias en Altium)
    - Flujo diario y orden correcto de operaciones
    - Caso A: modificar un esquematico
    - Caso B: modificar una libreria (recompilar y copiar la IntLib)
    - Resolucion de conflictos en binarios
    - Reglas de convivencia, ramas, convencion de commits
    - Errores frecuentes y soluciones
    - Alternativa con GitHub Desktop
2026-10-24 cambio de la resistencia de 0603
2026-10-24 DOC: amplia la seccion de ramas en CONTRIBUTING.md
    - Ciclo completo de una rama en 9 pasos
    - Por que sirven aunque los binarios no se fusionen
    - Ejemplo de dos personas trabajando en paralelo
    - Como integrar main en la rama antes del merge
    - Reglas, nombres y resolucion de conflictos
    - Resumen imprimible
2026-10-24 Correccion de errores
2026-10-26 conexíones de usb y wifi halow
2026-11-01 BOM: add bomv1
2026-11-01 DOC: agrega outputs del proyecto (netlist, BOM y reporte)
2026-11-02 SCH:add main.Sch wires
2026-11-05 uart web demo
2026-11-05 Actualizacion de SPIS
2026-11-05 cambio de Diodo a 2A
2026-11-06 Actulizacion de footprint
2026-11-07 Inicio de la PSB
2026-11-07 PCB: init
2026-11-08 PCB sin rutear
2026-11-11 PCB: Board shape
2026-11-12 Creacion de Poligonos
2026-11-12 PCB: polygons
